pecostm32/MCU_MIDI_audio_carrier_boards/ESP32Soundboard/Hardware/IMG_20260201_112647.jpg

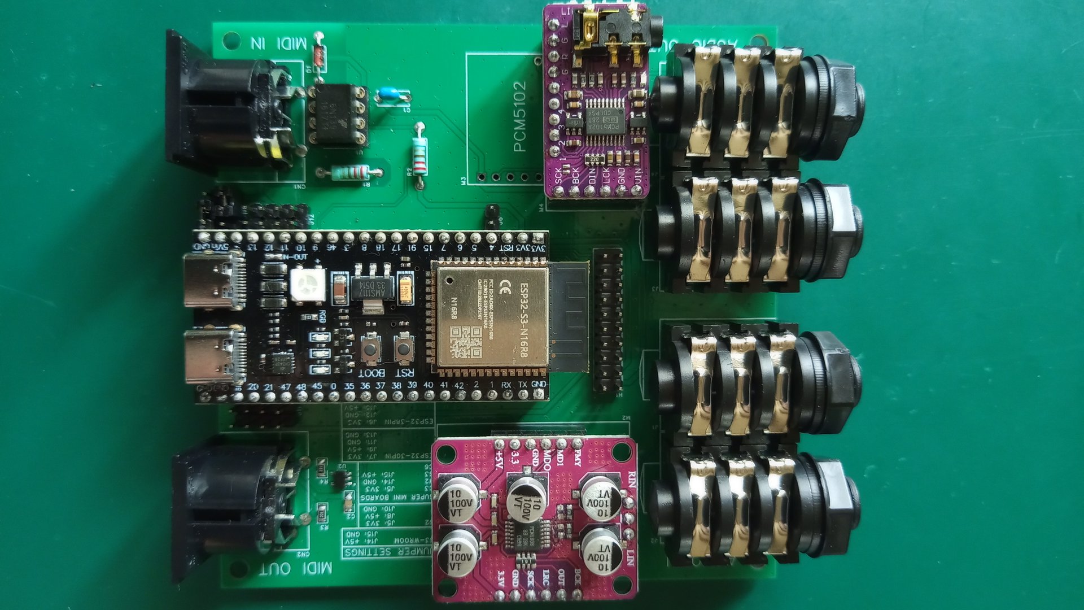
ESP32Soundboard/Hardware/IMG_20260201_112647.jpg
