pecostm32/MCU_MIDI_audio_carrier_boards/STM32F411Soundboard/readme

This board is designed for the STM32F411 based blackpill module.

In the software folder there is an Arduino sketch for testing the MIDI interface in a loop back setup. (MIDI in connected to MIDI out)
I use the Generic STM32F4 series board with under the tools menu the Blackpill F411CE selected for Board part number.
USB support set to "CDC (generic 'Serial' supersede U(S)ART)

Some of the used component are sourced from Aliexpress:
Stereo mini jack PJ-327A  https://www.aliexpress.com/item/1005005394455266.html
Mono 6.35mm jack          https://www.aliexpress.com/item/1005006612950070.html
5 pin DIN connector       https://www.aliexpress.com/item/1005006314983600.html
SN74LVC126                https://www.aliexpress.com/item/1005006250704206.html
PCM1808 ADC module        https://www.aliexpress.com/item/1005008885079639.html
PCM5102 DAC module        https://www.aliexpress.com/item/1005006104038963.html
PCM5102 DAC module        https://www.aliexpress.com/item/1005006829178513.html
