pecostm32/MCU_MIDI_audio_carrier_boards/ESP32Soundboard/Hardware/jumper settings.pdf

J15 J14
J5 J9 J13 J12 | J6

J8 J10 J7 J11

J15 J14
J5 J9 J13 J12 | J6

J8 J10 J7 J11

J15 J14
J5 J9 J13 J12 | J6

J8 J10 J7 J11

J15 J14
J5 J9 J13 J12 | J6

J8 J10 J7 J11

J15 J14
J5 J9 J13 J12 | J6

J8 J10 J7 J11

J15 J14
J5 J9 J13 J12 | J6

J8 J10 J7 J11

J15 J14
J5 J9 J13 J12 | J6

J8 J10 J7 J11

J15 J14
J5 J9 J13 J12 | J6

J8 J10 J7 J11

## ESP32 S3 WROOM

## ESP32 WROOM 30 PIN

## ESP32 WROOM 38 PIN

## ESP32 S2 MINI

## ESP32 C3 SUPER MINI

## ESP32 C6 SUPER MINI

## ESP32 S3 SUPER MINI

## ESP32 H2 SUPER MINI
