pecostm32/MCU_MIDI_audio_carrier_boards/ESP32Soundboard/Hardware/IMG_20260201_113353.jpg

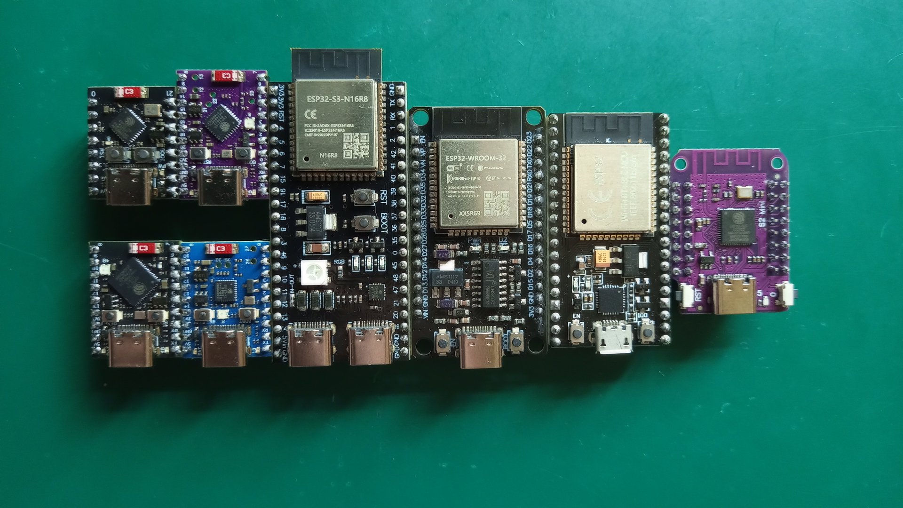
ESP32Soundboard/Hardware/IMG_20260201_113353.jpg
