pecostm32/MCU_MIDI_audio_carrier_boards/STM32F411Soundboard/Hardware/IMG_20260210_184834.jpg

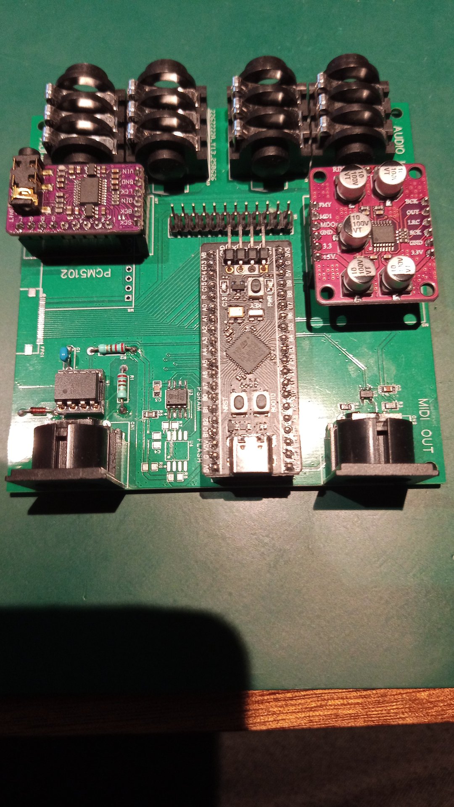
STM32F411Soundboard/Hardware/IMG_20260210_184834.jpg
