pecostm32/MCU_MIDI_audio_carrier_boards/ESP32Soundboard/Hardware/design guide.pdf

5V
GND
GPIO0 | 3V3

GPIO5
GPIO6
GPIO7
GPIO8
GPIO9
GPIO10
GPIO20
GPIO21

GPIO24
GPIO23

GPIO43
GPIO44

GPIO4
GPIO3
GPIO2
GPIO1
GPIO0

GPIO14
GPIO13
GPIO12
GPIO11

GPIO19
GPIO18
GPIO15

GPIO16
GPIO17

GPIO33
GPIO35
GPIO37
GPIO39

GPIO34
GPIO36
GPIO38
GPIO40
S2F | C6_SM | S3_SM | H2_SM | C3_SM | C3_SM | H2_SM
| | | | | | 5V GND 3V3

GPIO9

GPIO5 | GPIO10

GPIO4

GPIO3

GPIO2

GPIO1

GPIO0

GPIO8

S3_SM

5V
GND
3V3
GPIO13
GPIO12
GPIO11

GPIO9

GPIO10

GPIO8

GPIO5
GPIO6
GPIO7

GPIO4

GPIO3

GPIO2

GPIO1

C6_SM

5V
GND
3V3
GPIO20

GPIO14
GPIO9
GPIO8

GPIO5
GPIO6
GPIO7

GPIO4

GPIO3

GPIO2

GPIO1

S2F

USB CONNECTOR

EN

5V
GND GND
GPIO16 GPIO17

GPIO5

GPIO6 GPIO7
GPIO4
GPIO2 GPIO3
GPIO1

GPIO18 GPIO21

3V3

GPIO8 GPIO9

GPIO12 GPIO13
GPIO10 GPIO11

GPIO14

S2F | Has a 700mil spacing on the inner pins Option is to overlay the pads such that the 3V3 of the S2F is on top of the 3V3 of the 4 super mini boards Only issue is with the C6 super mini that GPIO8 is overlapped by the EN pin and should thus not be used. The USB connectors can than be on the same distance from the carrier board edge
C6_SM S3_SM H2_SM C3_SM | These four super mini boards all have a 600mil spacing on the pins, and only overlap with the S2F with one row of pins The three supply pins are on the same location so no problem in overlap. The GPIO matrix allows for full re allocation of the peripherals in software.

GND

GPIO21

GPIO19

GPIO27

GPIO2

GPIO1

GPIO26

GPIO35

GPIO39

GPIO33

GPIO22 | GPIO36 GPIO25

GPIO23

GPIO32

GPIO34

GND

5V

GPIO12
GPIO14

GPIO13

GPIO5

GPIO4

GPIO3

GPIO18

GPIO16
GPIO17

GPIO15

3V3

GPIO25

GPIO23

GPIO27

GND
GPIO21

GPIO19

GPIO22

GPIO2

GPIO1

GPIO0

GPIO35

GPIO39
GPIO36

GPIO34

GPIO33
GPIO32

GND

S3_WRM

GPIO45

GPIO48

GPIO47

GND
GND

GPIO21

GPIO19
GPIO20

GPIO2
GPIO1

GPIO0
GPIO35

GPIO37

GPIO39

GPIO36

GPIO38

GPIO40
GPIO41
GPIO42

GPIO43

GPIO44

GND

GPIO9

GPIO10

GPIO11

GND

5V

GPIO12
GPIO14

GPIO13

GPIO5

GPIO4

GPIO26

GPIO3

GPIO18

GPIO16

GPIO8

GPIO17

GPIO15

GPIO7

GPIO6

3V3

S3_WRM

GPIO9

GPIO10

GPIO11

GND
5V

GPIO12

GPIO14
GPIO13

GPIO5
GPIO4

GPIO46
GPIO3

GPIO18

GPIO16

GPIO8

GPIO17

GPIO15
GPIO7
GPIO6

3V3

RST

3V3

ESP32_30 | ESP32_38 | ESP32_38 | ESP32_30
EN | EN

600 mil
600 mil
600 mil
600 mil
700 mil
900 mil

1000 mil

900 mil

1000 mil

Pins overlapping on this side. (Except for the inside row of the S2F)

Need a special component and footprint for this.
Has to have 6 rows of pads, with 22 pads on the right and left side for the 1000 mil ESP32-S3-WROOM board The schematic symbol for this needs 89 pins
Pins overlapping | Pins overlapping | Pins overlapping

GPIO15

C3 UART 2x, SPI 3x, I2C 1x, I2S 1x

C6 UART 3x, SPI 3x, I2C 1x, I2S 1x

H2 UART 2x, SPI 3x, I2C 1x, I2S 1x
S3 UART 3x, SPI 4x, I2C 2x, I2S 2x, SDIO host 1x
S2 UART 2x, SPI 4x, I2C 2x, I2S 1x

ESP32 UART 3x, SPI 4x, I2C 2x, I2S 1x, SDIO host 1x
