pecostm32/MCU_MIDI_audio_carrier_boards/RPiPicoSoundboard/Hardware/PCB_RPiPicoSoundBoard_SG_2026-02-23.pdf

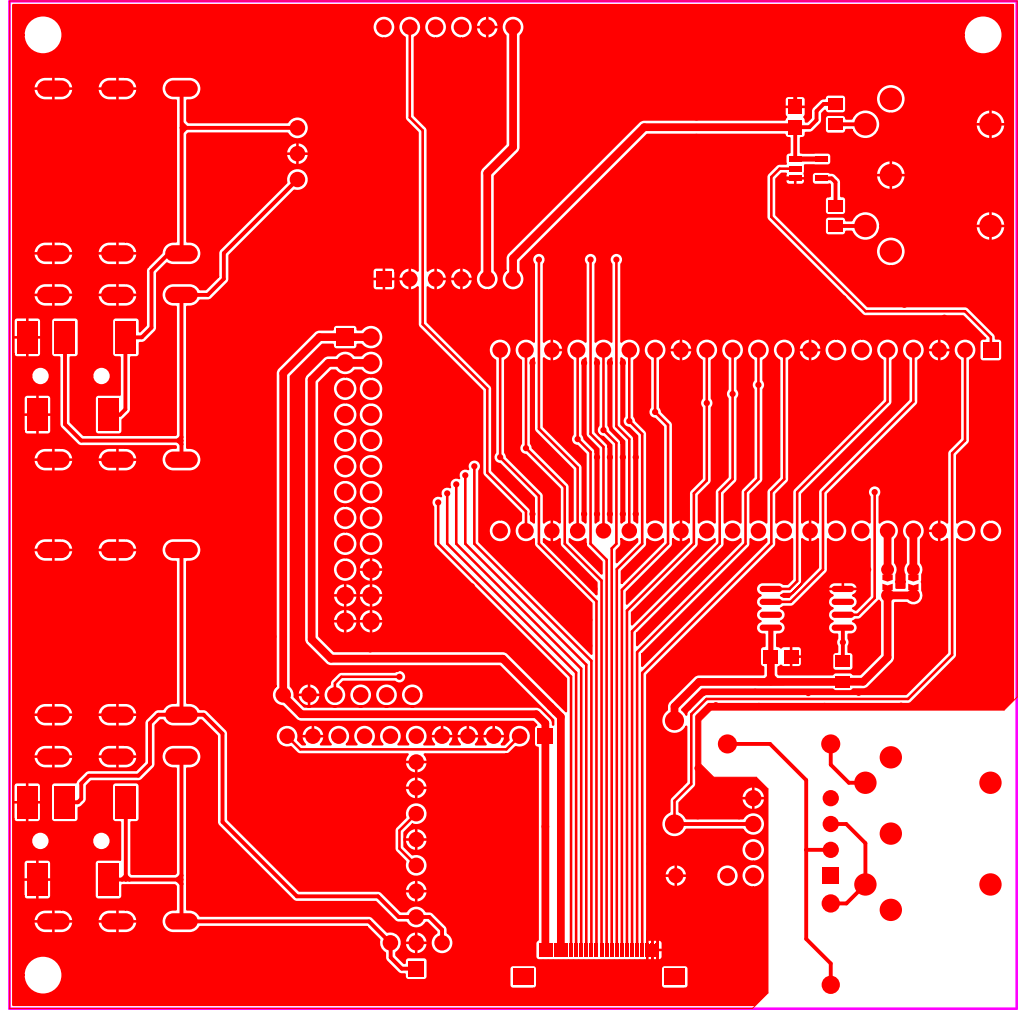
[picture p8: page 1]

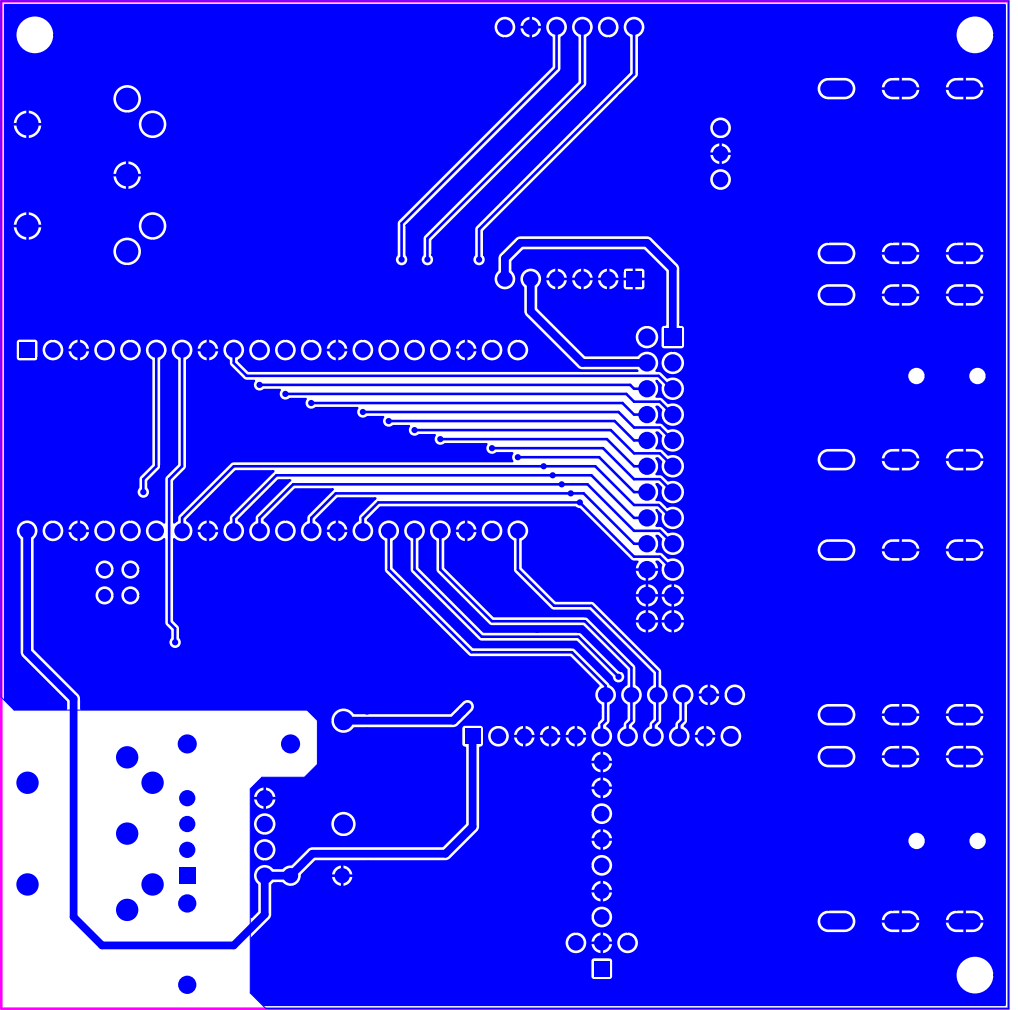
[picture p9: page 2]

# ADC MODULE PCM5102

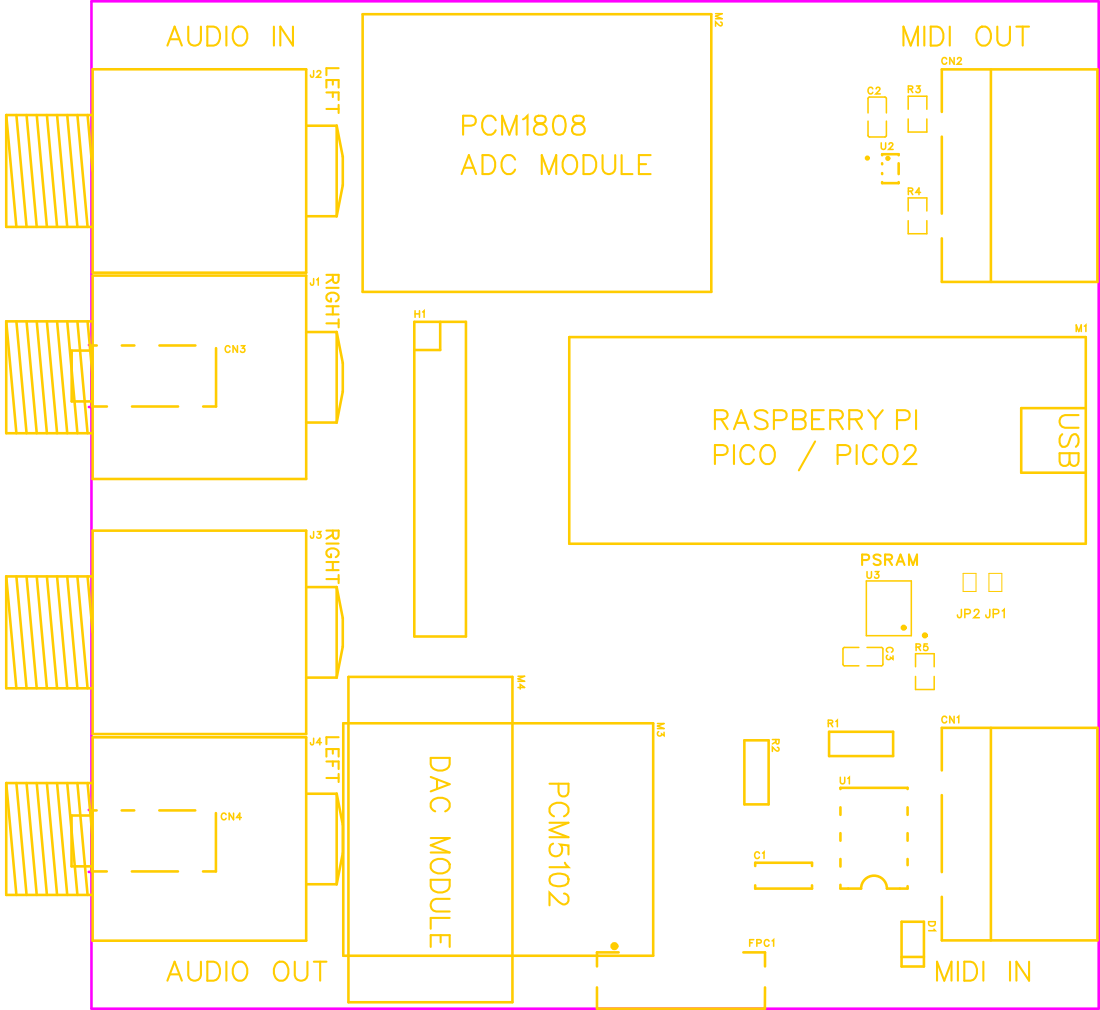
[picture p10: page 3]

LEFT RIGHT
