pecostm32/MCU_MIDI_audio_carrier_boards/RPiPicoSoundboard/Hardware/SCH_RPiPicoSoundBoard_SG_2026-02-23.pdf

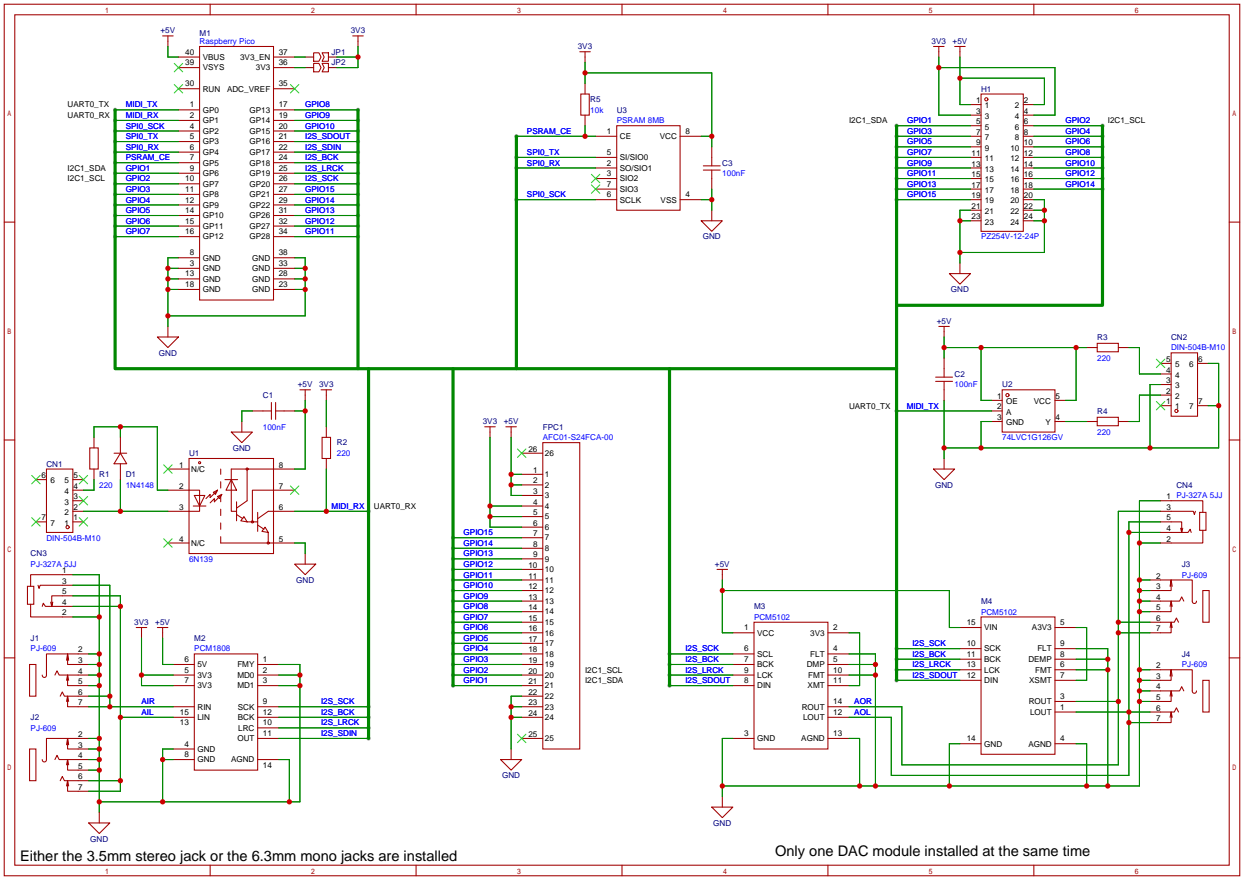
[picture p11: page 1]

Either the 3.5mm stereo jack or the 6.3mm mono jacks are installed

Only one DAC module installed at the same time
