pecostm32/MCU_MIDI_audio_carrier_boards/STM32F411Soundboard/Hardware/PCB_F411SoundBoard_SG_2026-02-11.pdf

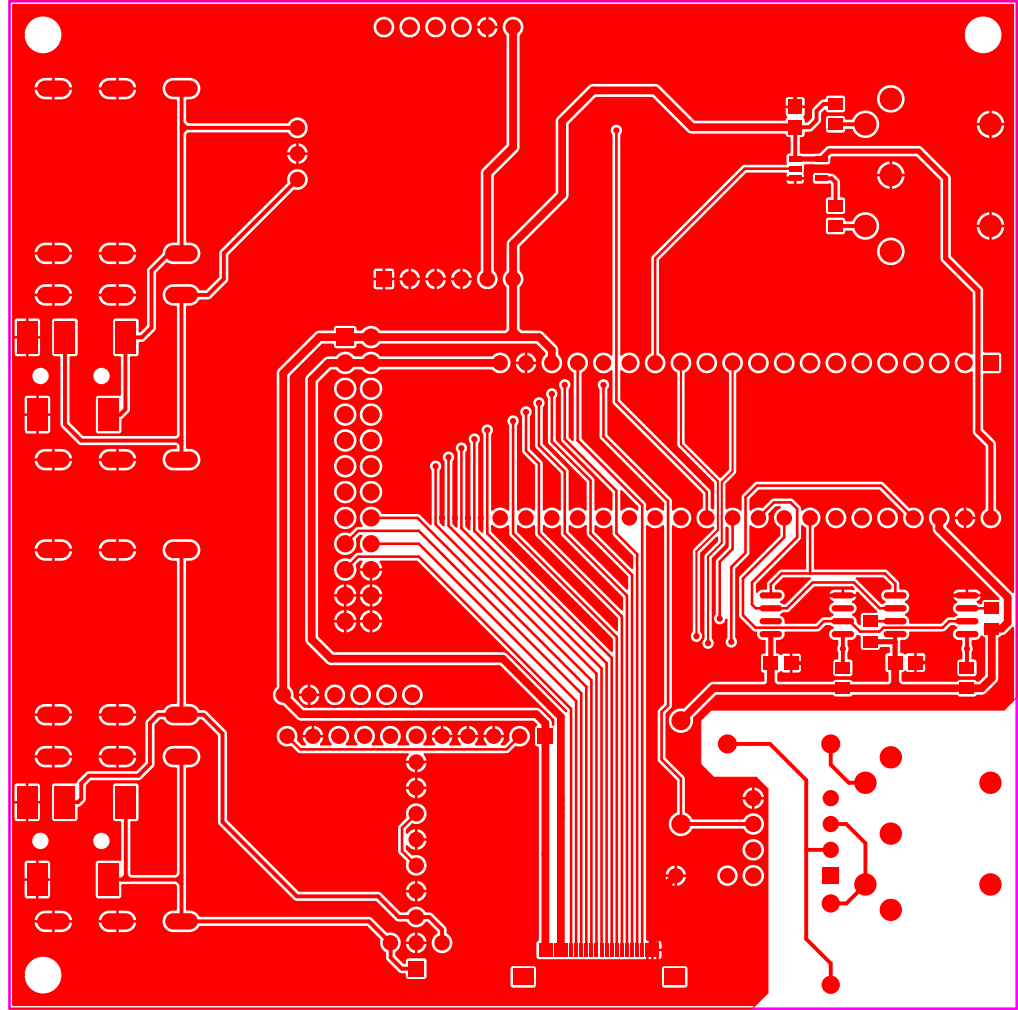
[picture p12: page 1]

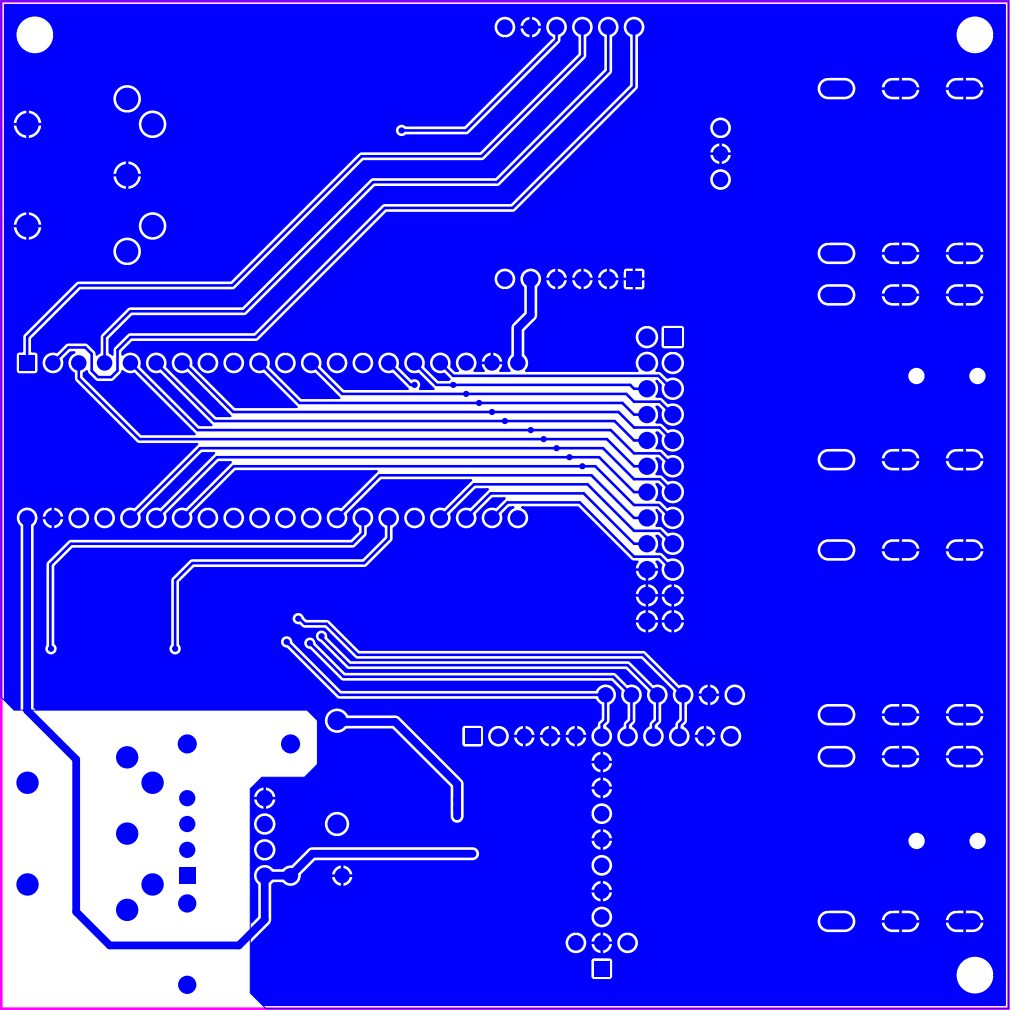
[picture p13: page 2]

# ADC MODULE PCM5102

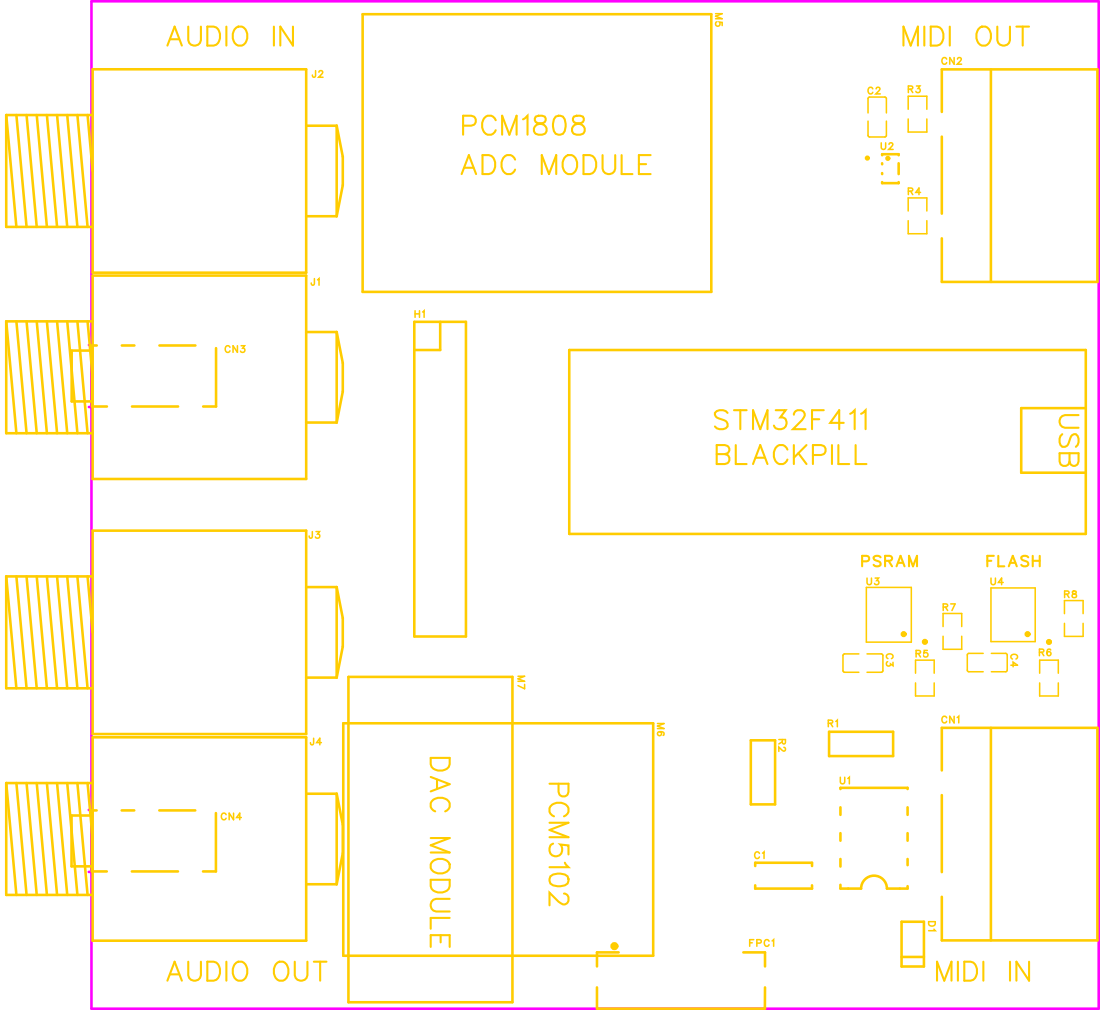
[picture p14: page 3]
