pecostm32/MCU_MIDI_audio_carrier_boards/STM32F411Soundboard/Hardware/SCH_F411SoundBoard_SG_2026-02-11.pdf

# PA7 33 PA6 32 PA5 31 PA4 30 PA3 29 PA2 28 PA1 27 PA0 26

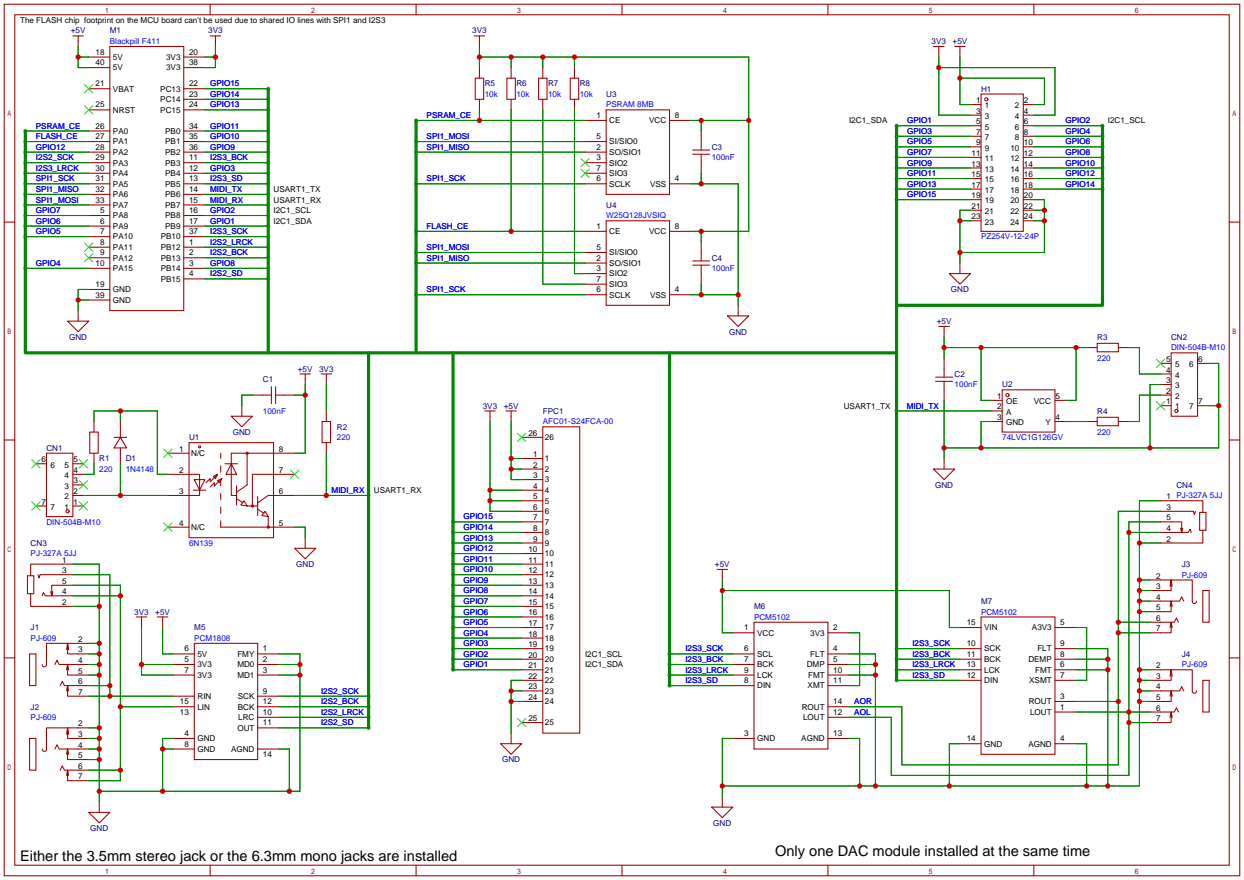
[picture p15: page 1]

The FLASH chip footprint on the MCU board can't be used due to shared IO lines with SPI1 and I2S3

Either the 3.5mm stereo jack or the 6.3mm mono jacks are installed

Only one DAC module installed at the same time
