pecostm32/MCU_MIDI_audio_carrier_boards/ESP32Soundboard/Hardware/PCB_ESP32SoundBoard_1_2026-02-01.pdf

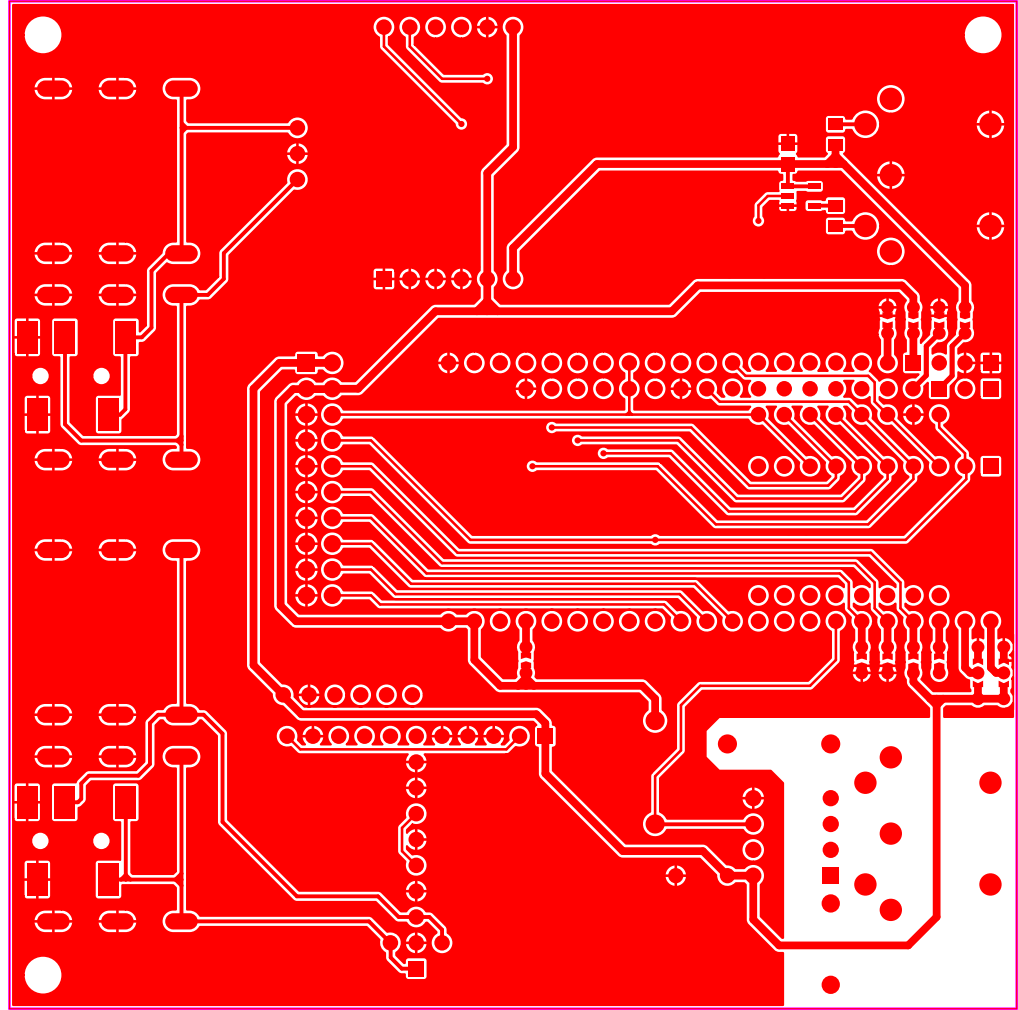
[picture p16: page 1]

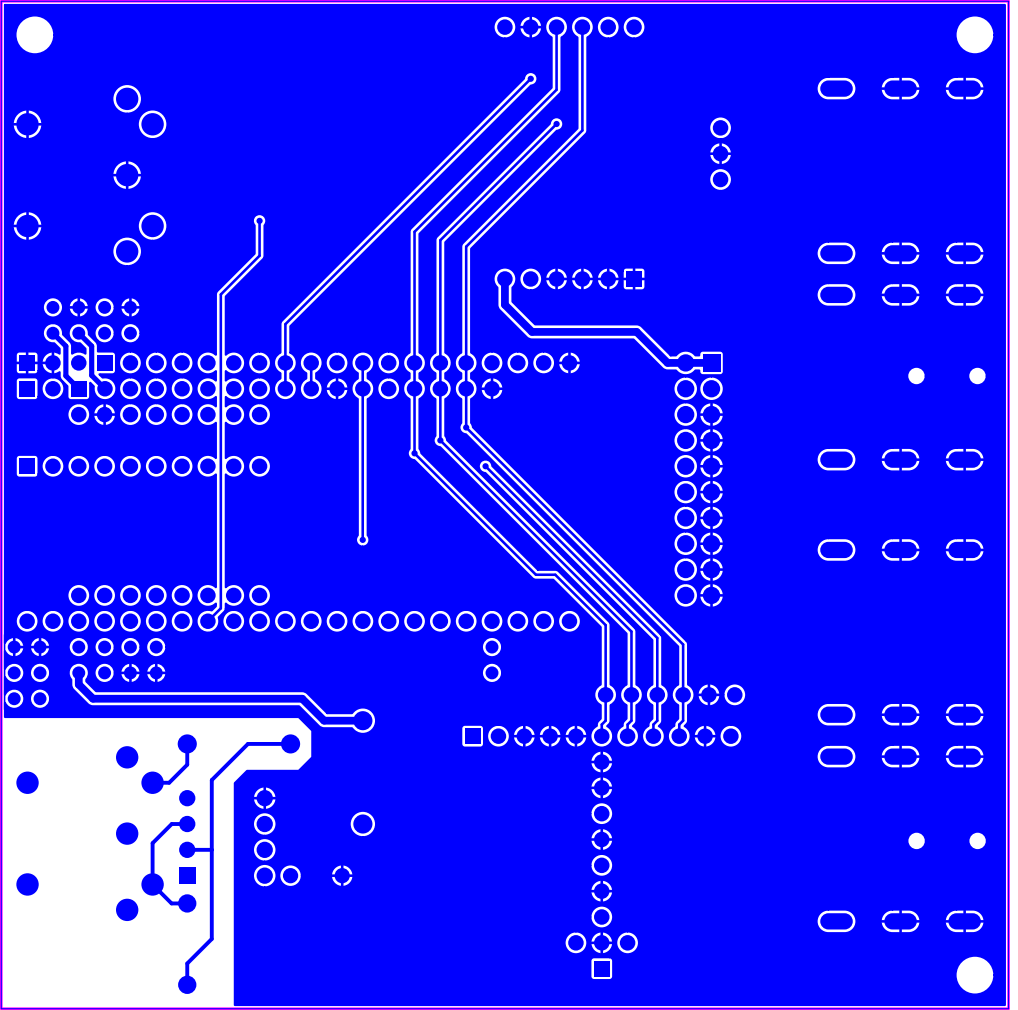
[picture p17: page 2]

# PCM1808 ADC MODULE

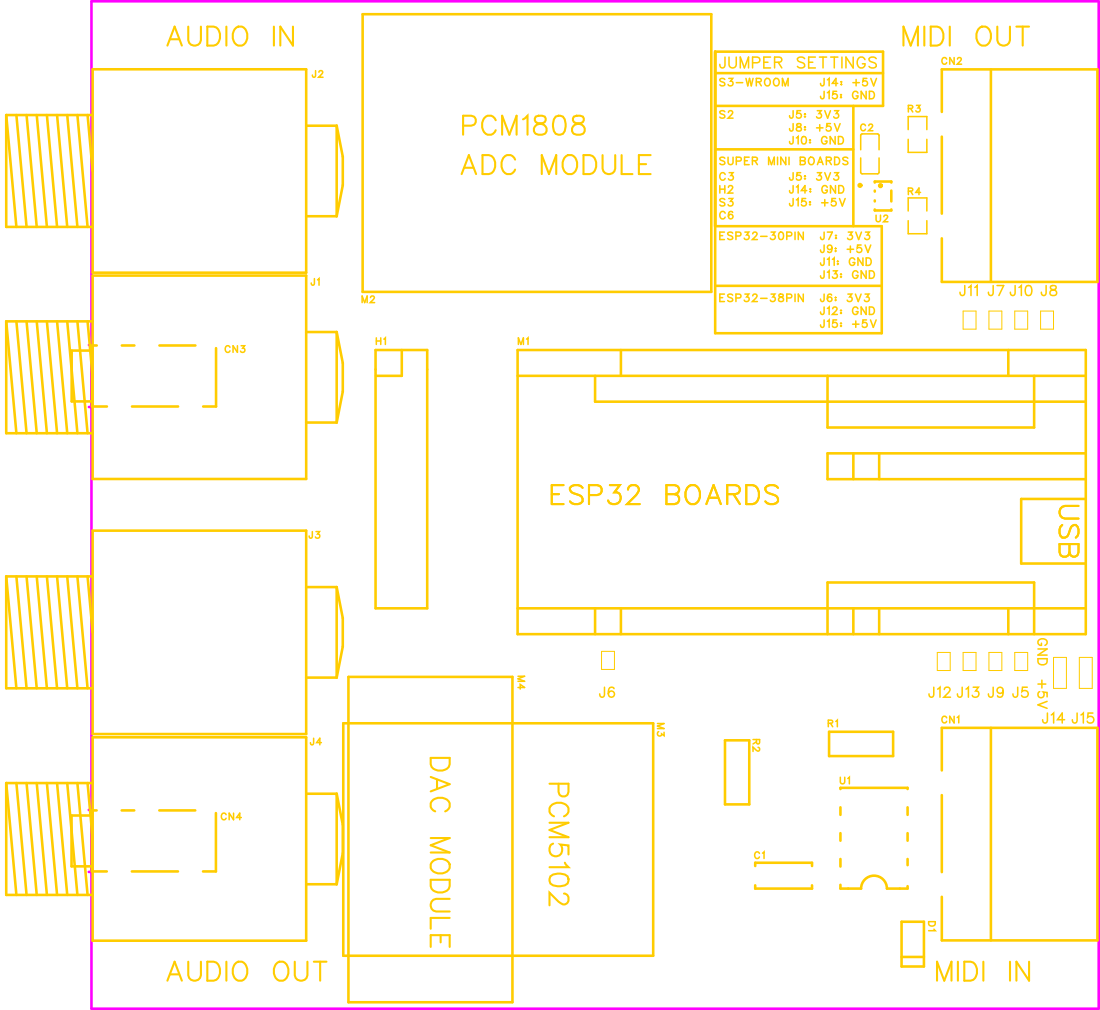
[picture p18: page 3]

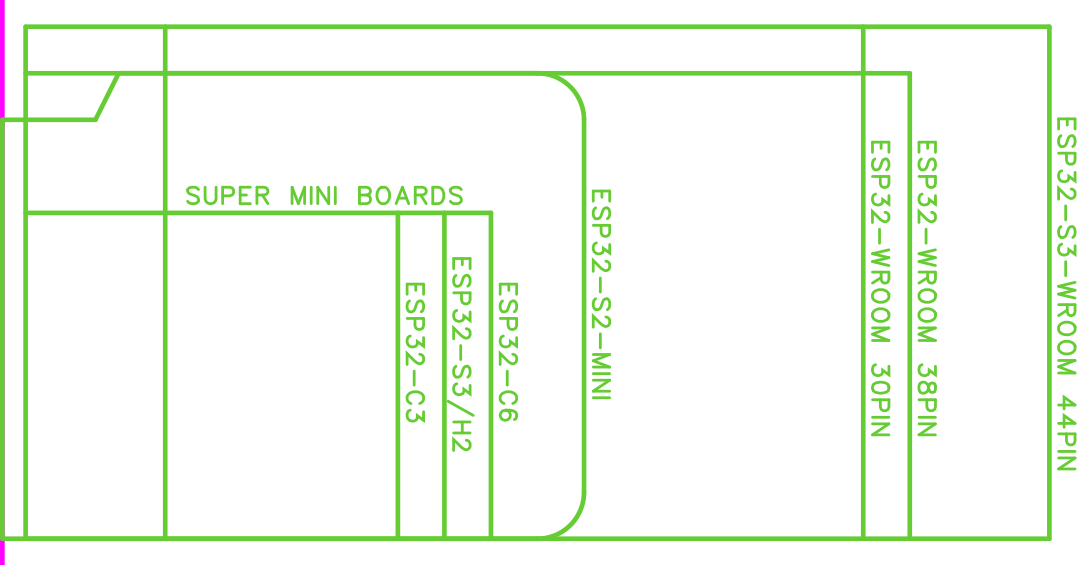
[picture p19: page 4]
