pecostm32/MCU_MIDI_audio_carrier_boards/ESP32Soundboard/Hardware/schematic.pdf

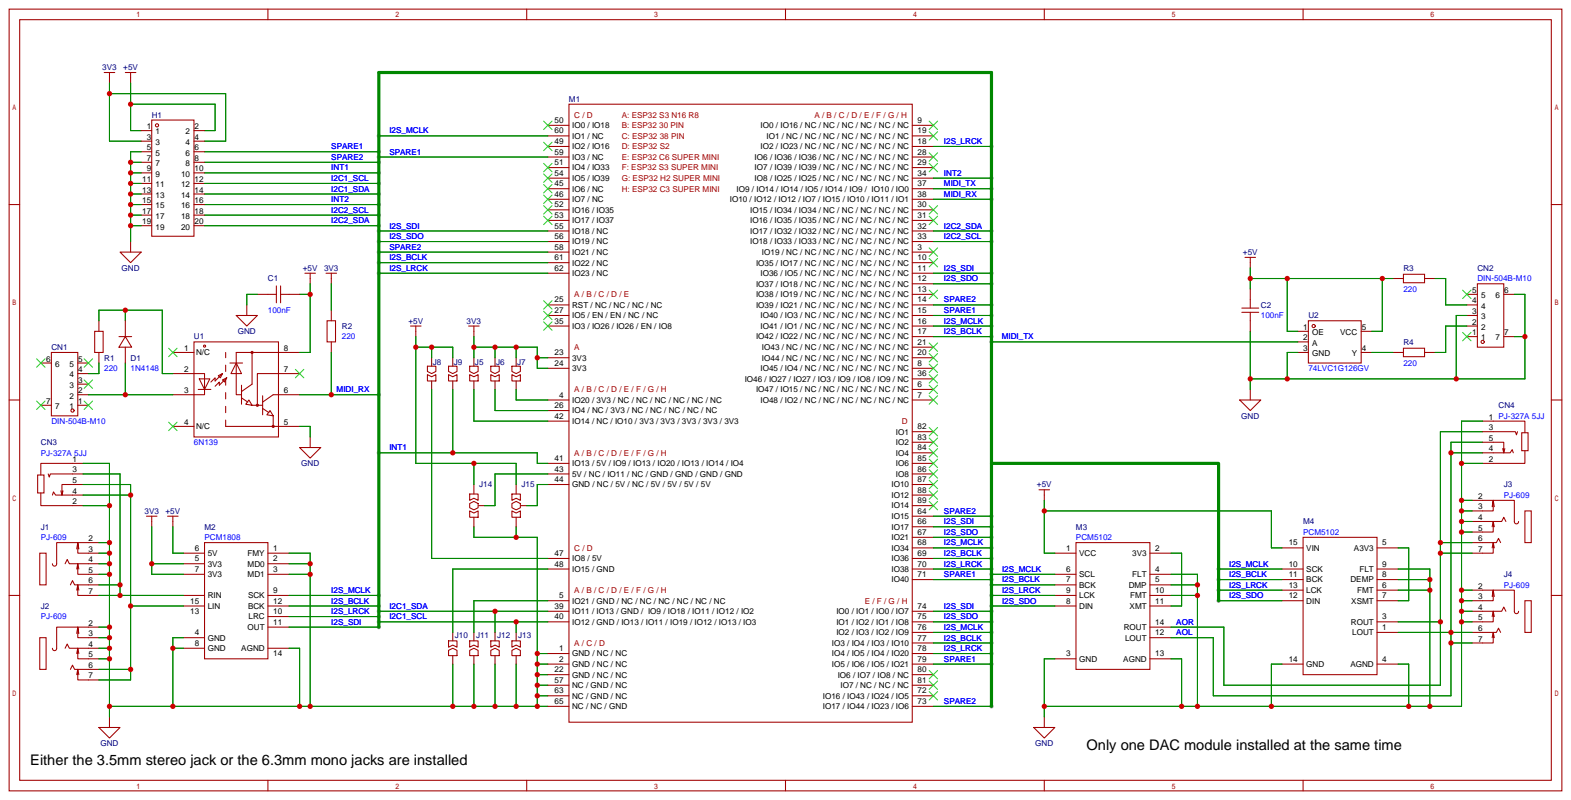
[picture p20: page 1]

RST / NC / NC / NC / NC 25

5V / NC / IO11 / NC / GND / GND / GND / GND 43
GND / NC / 5V / NC / 5V / 5V / 5V / 5V 44

IO21 / GND / NC / NC / NC / NC / NC / NC 5
IO11 / IO13 / GND / IO9 / IO18 / IO11 / IO12 / IO2 39
IO12 / GND / IO13 / IO11 / IO19 / IO12 / IO13 / IO3 40

Only one DAC module installed at the same time

Either the 3.5mm stereo jack or the 6.3mm mono jacks are installed
