pecostm32/MCU_MIDI_audio_carrier_boards/(list of files, drawings)

Other design files:
ESP32Soundboard/Hardware/EasyEDApro/ProPrj_ESP32SoundBoard_2026-02-01.epro
RPiPicoSoundboard/Hardware/EasyEDApro/ProPrj_RPiPicoSoundBoard_2026-02-23.epro
STM32F411Soundboard/Hardware/EasyEDApro/ProPrj_F411SoundBoard_2026-02-11.epro
